alexbrsc66/MACT/hardware/MACT-adapter-rev1.0-bottom.png

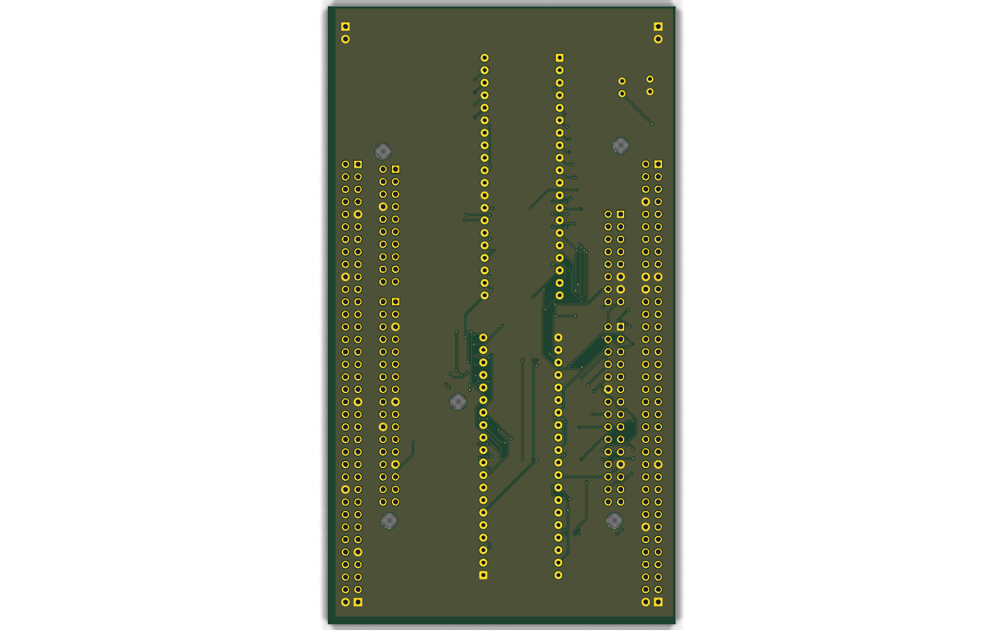
hardware/MACT-adapter-rev1.0-bottom.png
