alexbrsc66/MACT/hardware/3d/dip40-protector.stl

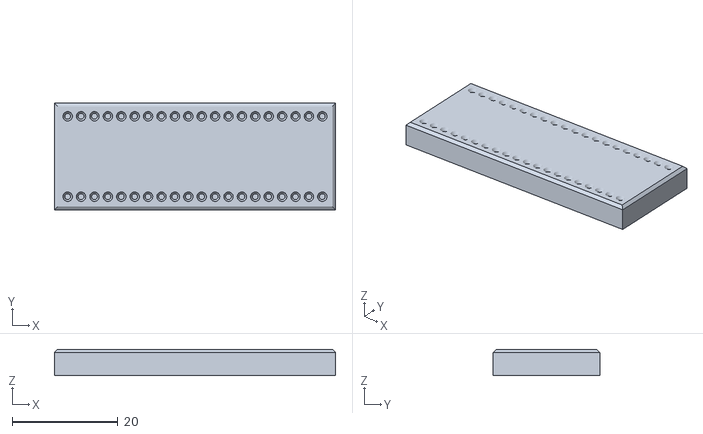
[picture p15: CAD file, 2026-10-29]
hardware/3d/dip40-protector.stl
53.3 x 20.2 x 5.00
