alexbrsc66/MACT/hardware/MACT-adapter-rev1.0-pcb.pdf

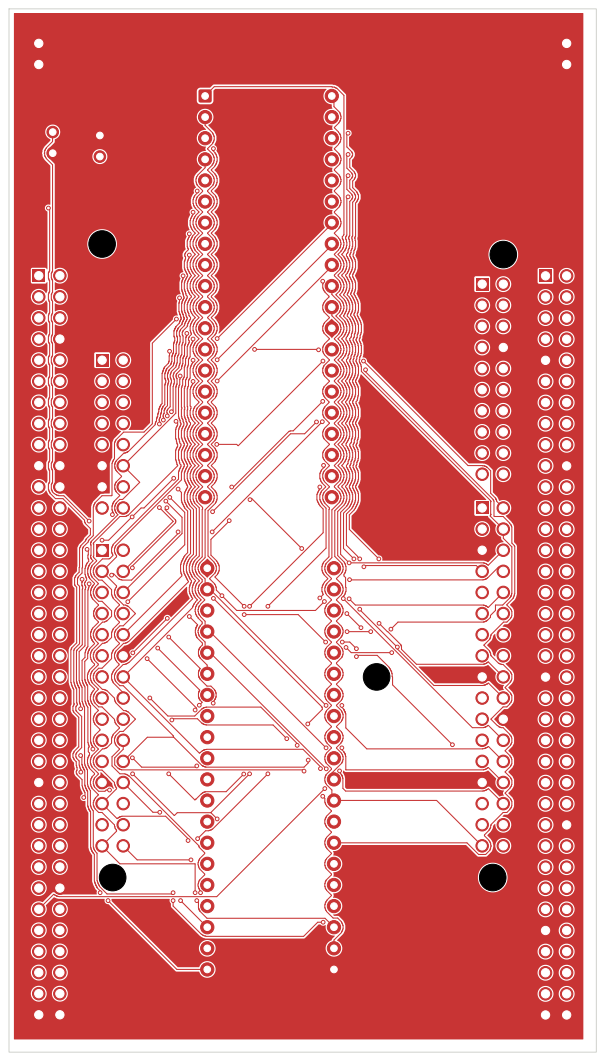
[picture p16: page 1]

Nucleo: open SB73 (CN10-28 = PE6), remove LD2 (PE1 = A1)
Hand mods: CN9-26 to CN9-27 (D1), CN10-28 to CN10-8 (A14), opt. /SYNC to CN9-7
Multiple Arcade & Computer Tester - CPU socket adapter for NUCLEO-H723ZG

Size: A4 | Rev: 1.0
KiCad E.D.A. 10.0.4 | Id: 1/5

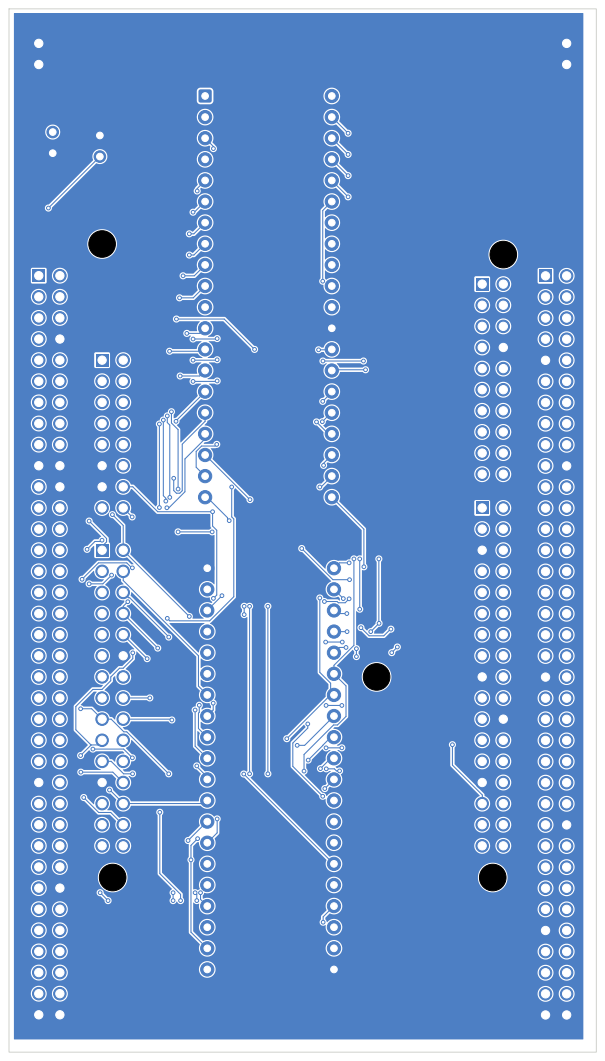
[picture p17: page 2]
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

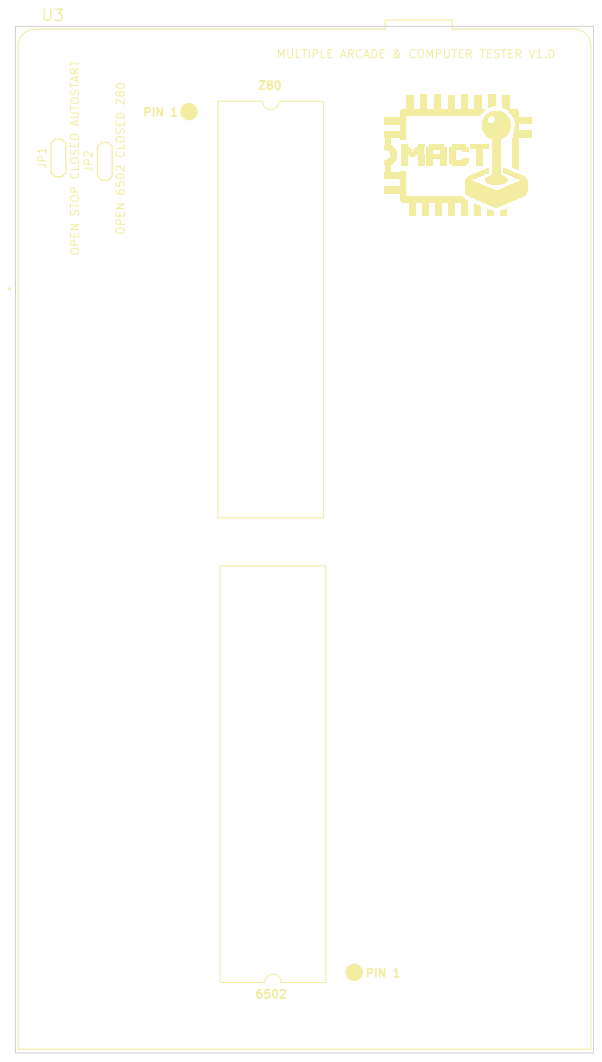
[picture p18: page 3]

MULTIPLE ARCADE & COMPUTER TESTER V1.0 PIN 1

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

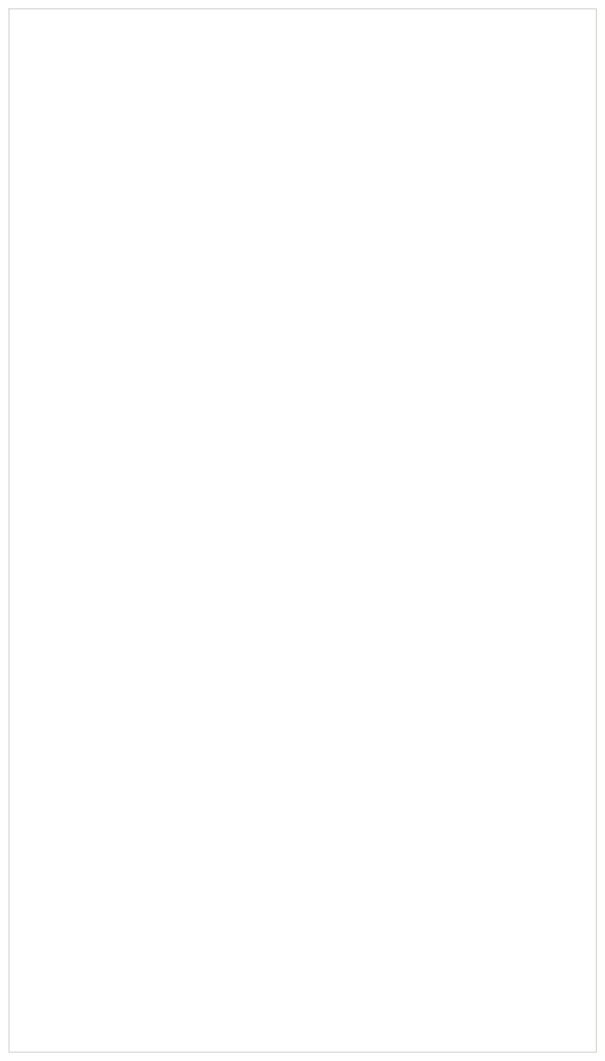
[picture p19: page 4]
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

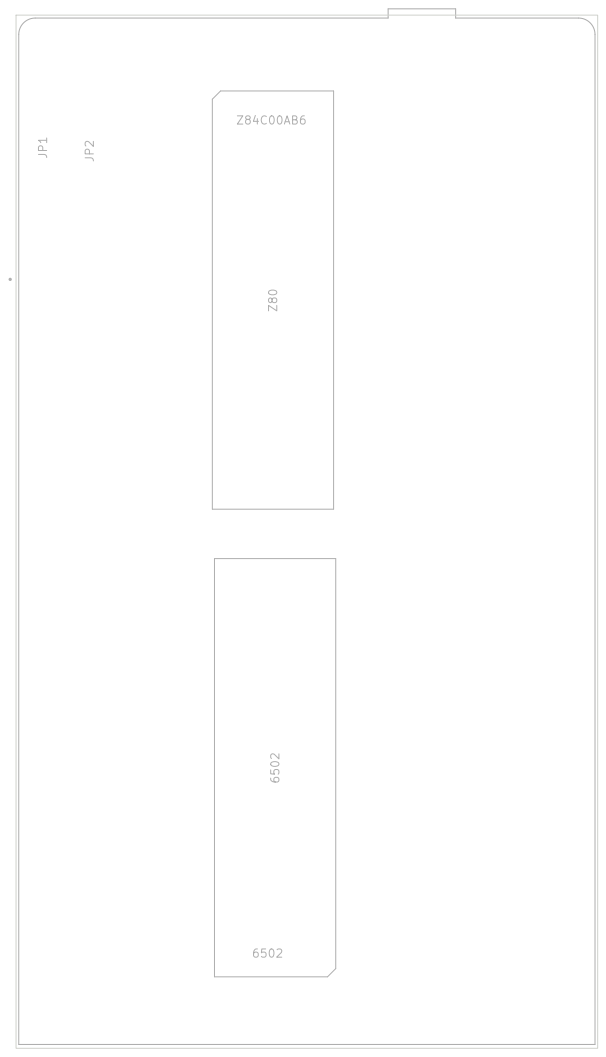
[picture p20: page 5]
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
