alexbrsc66/MACT/hardware/MACT-adapter-rev1.0-schematic.pdf

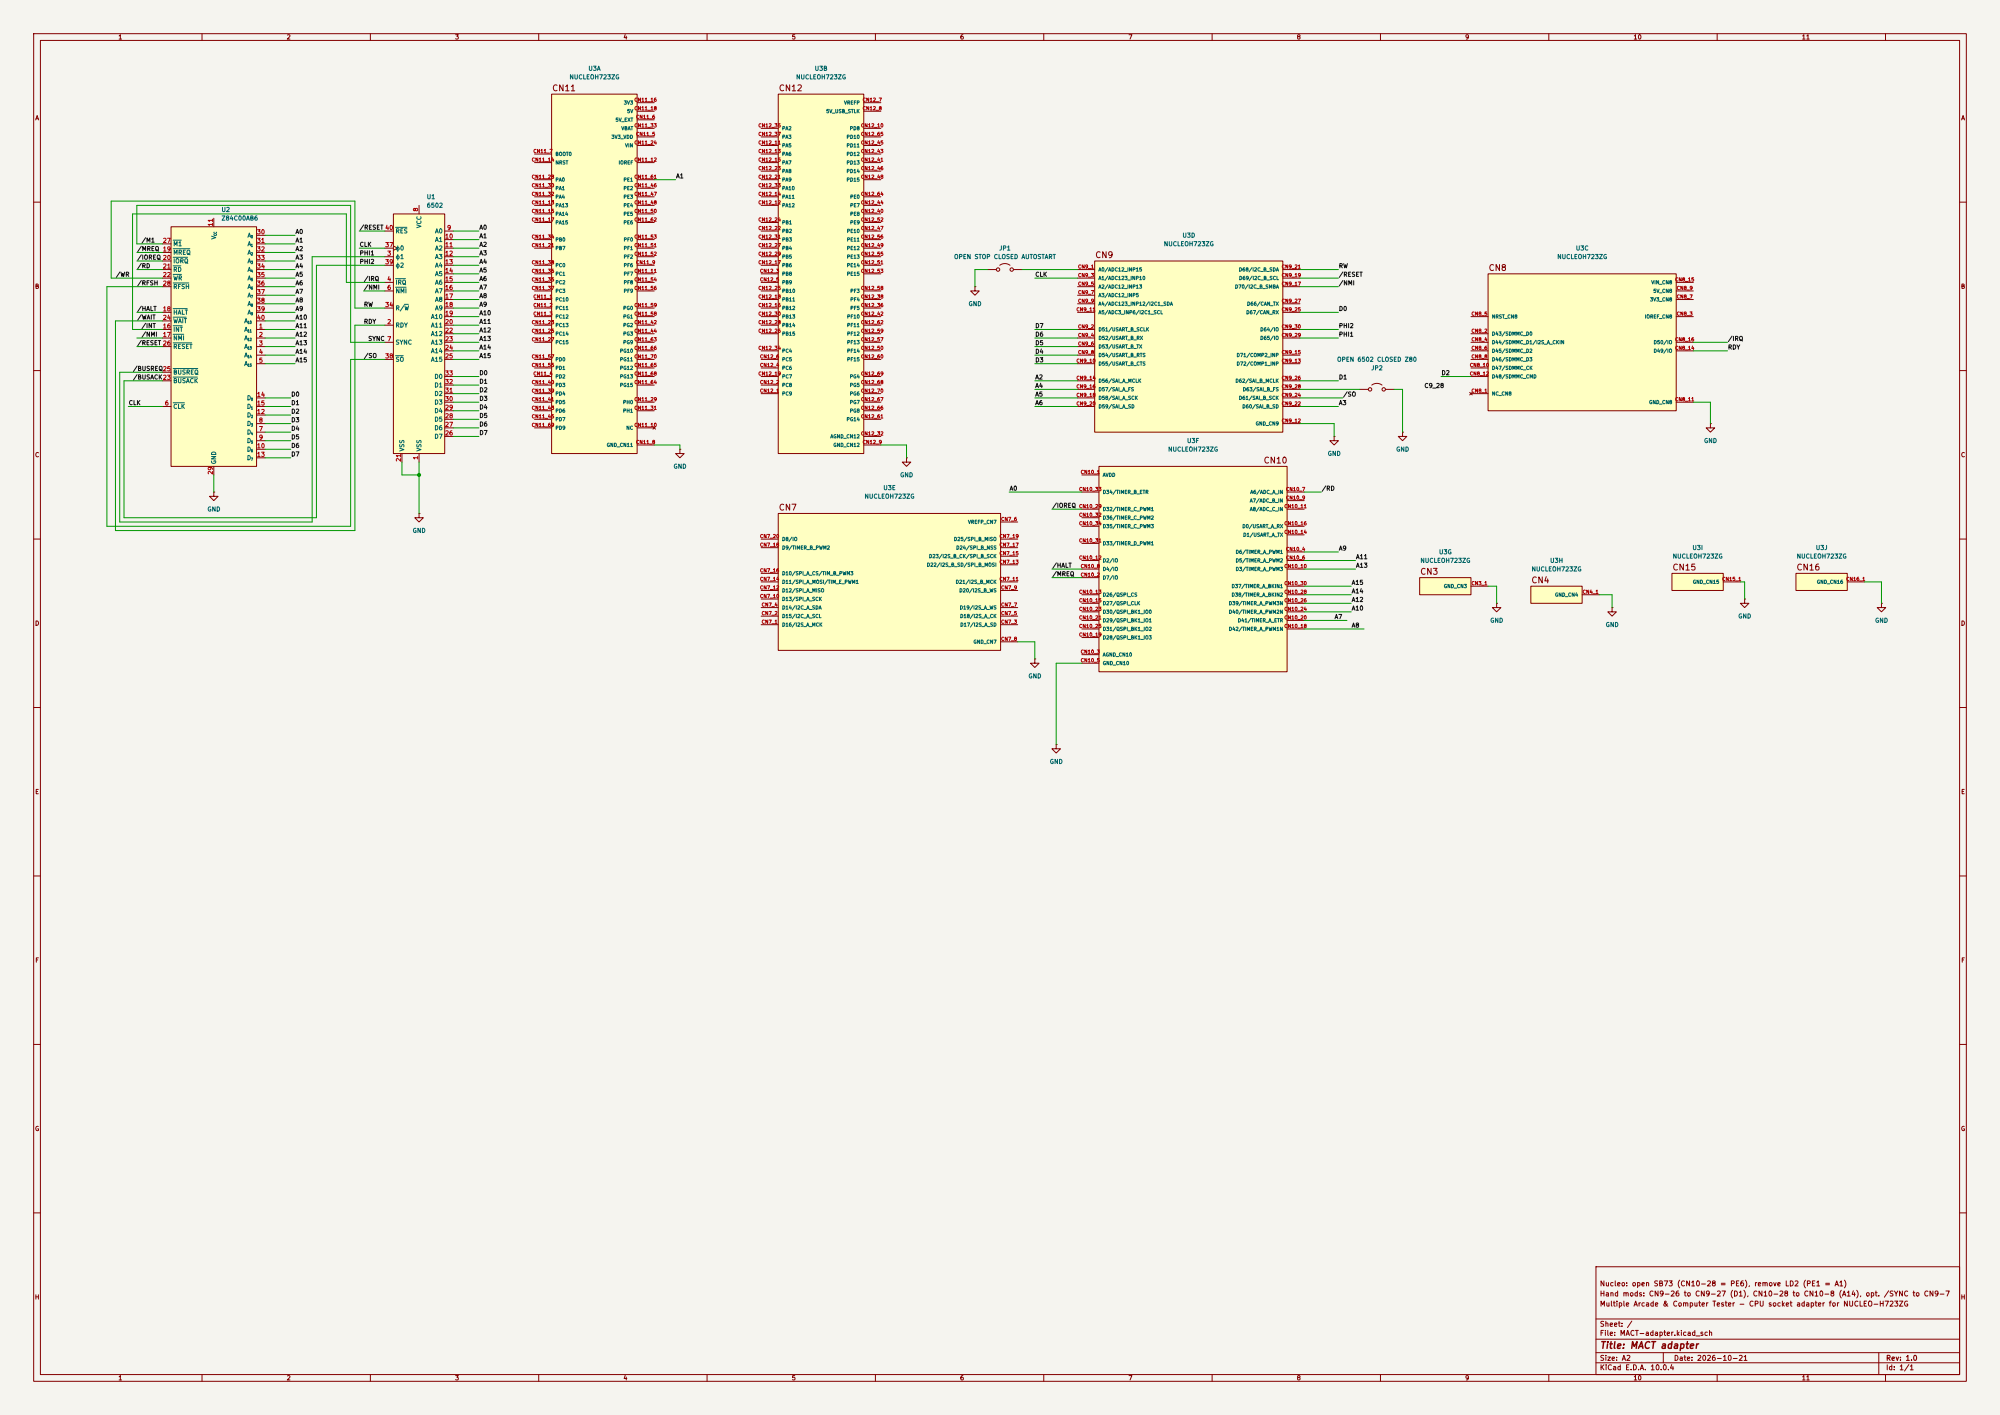
[picture p21: page 1]

INT 16 NMI 17 HALT 18 MREQ 19

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

Size: A2 | Rev: 1.0
KiCad E.D.A. 10.0.4 | Id: 1/1
