alexbrsc66/MACT/(commit log)

2026-10-29 MACT 1.0.0 - Multiple Arcade & Computer Tester
    First public release: firmware for NUCLEO-H723ZG (6502 and Z80 with real bus
    cycles), adapter PCB rev 1.0 with assembly notes and hand modifications,
    MACT Studio for Windows and macOS, board simulator, demos, documentation.
    [MACT-adapter-rev1.0-bom.csv, dip40-protector.stl]
2026-10-29 README: board simulator in the folder table and quick start
